Makerspace-Amiens-2025-26/MachineThatDraws-Groupe08/docs/images/pcb_3d.png

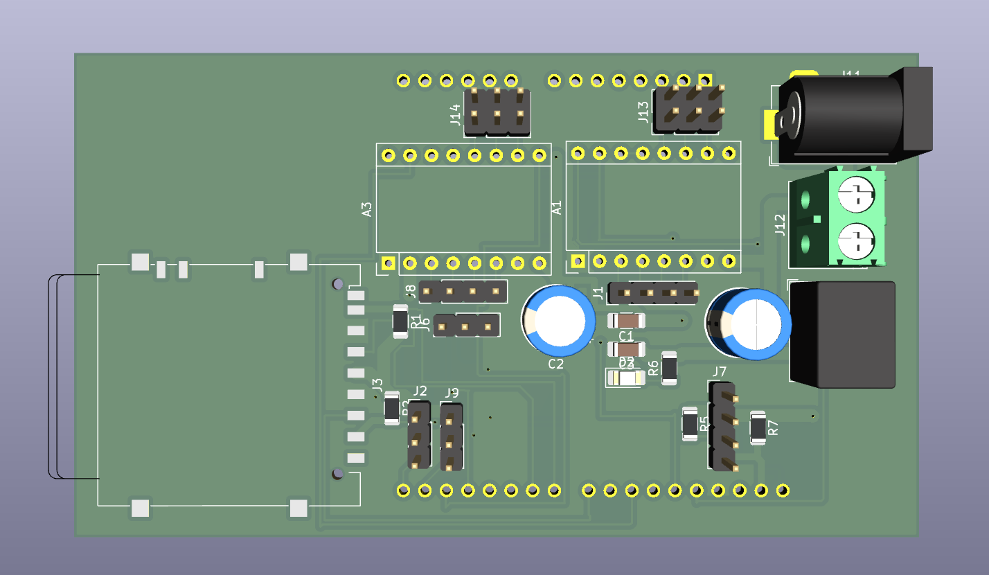
docs/images/pcb_3d.png
