Makerspace-Amiens-2025-26/MachineThatDraws-Groupe08/docs/images/pcb_routing.png

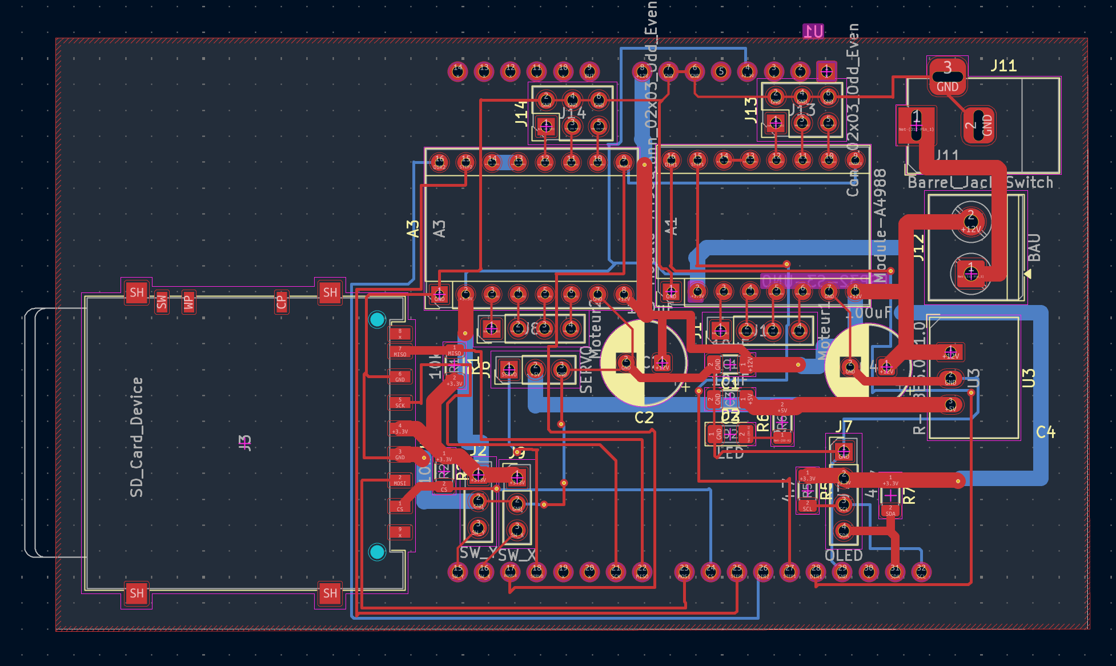
docs/images/pcb_routing.png
