Makerspace-Amiens-2025-26/MachineThatDraws-Groupe08/docs/images/poster_machine_1.png

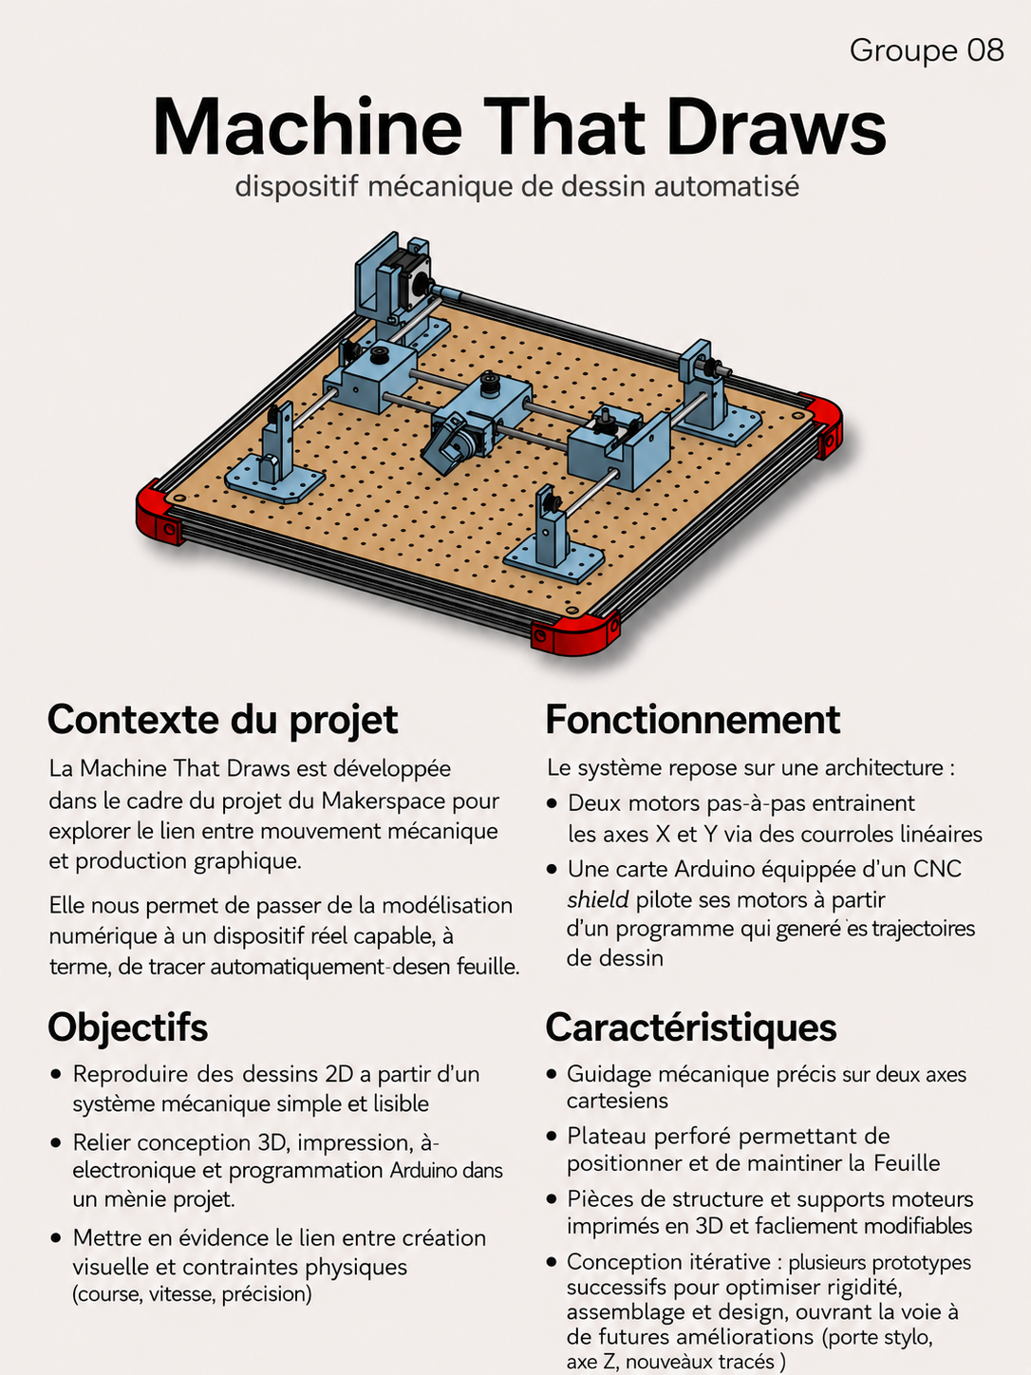
docs/images/poster_machine_1.png
