Makerspace-Amiens-2025-26/MachineThatDraws-Groupe08/docs/images/adaptateur.stl

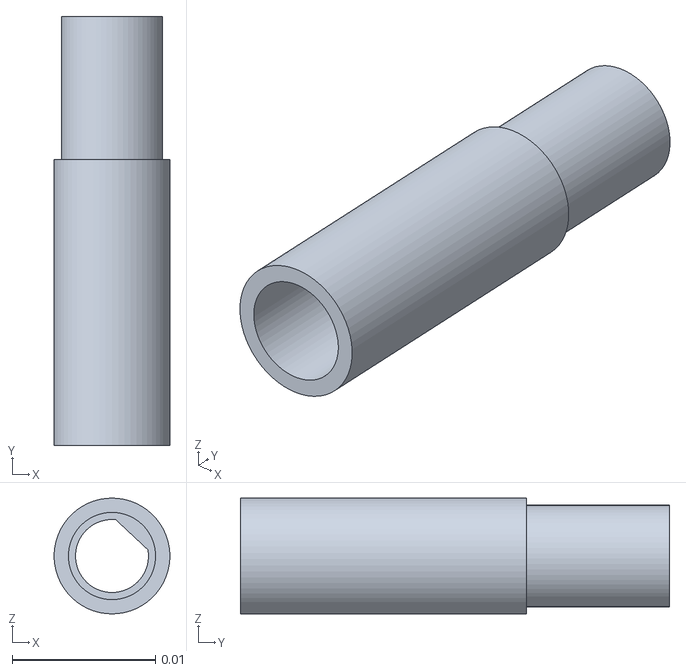
[picture p4: CAD file, 2026-06-24]
docs/images/adaptateur.stl
0.00809 x 0.03 x 0.0081
