Makerspace-Amiens-2025-26/MachineThatDraws-Groupe08/docs/images/support moteur.stl

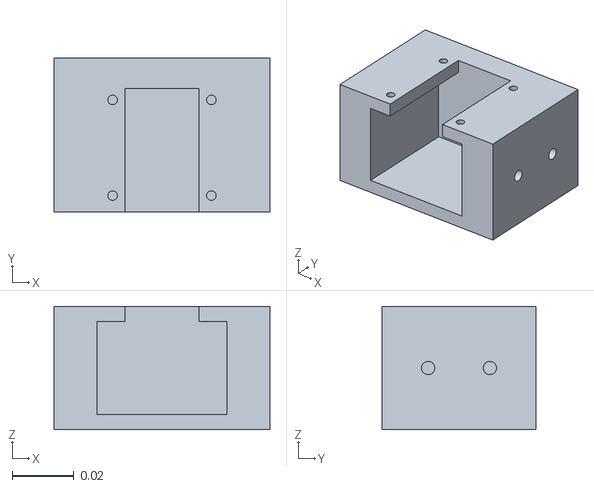
[picture p5: CAD file, 2026-06-24]
docs/images/support moteur.stl
0.07 x 0.05 x 0.04
