Makerspace-Amiens-2025-26/MachineThatDraws-Groupe08/docs/images/support double poulie.stl

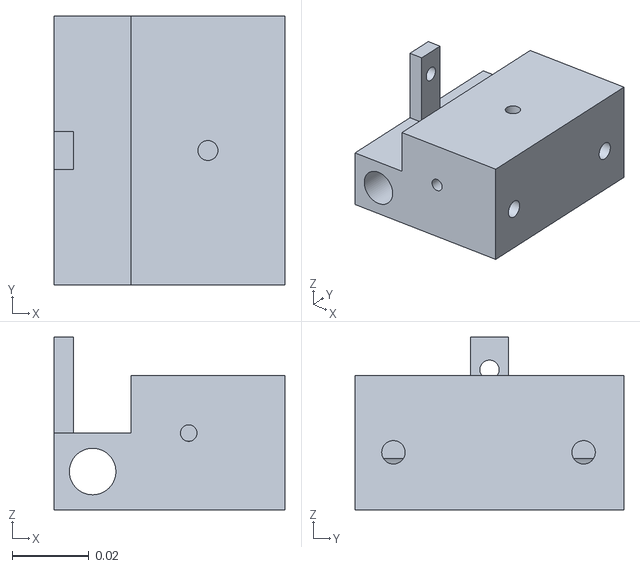
[picture p6: CAD file, 2026-06-24]
docs/images/support double poulie.stl
0.06 x 0.07 x 0.045
