Makerspace-Amiens-2025-26/MachineThatDraws-Groupe08/docs/images/support moteur double.stl

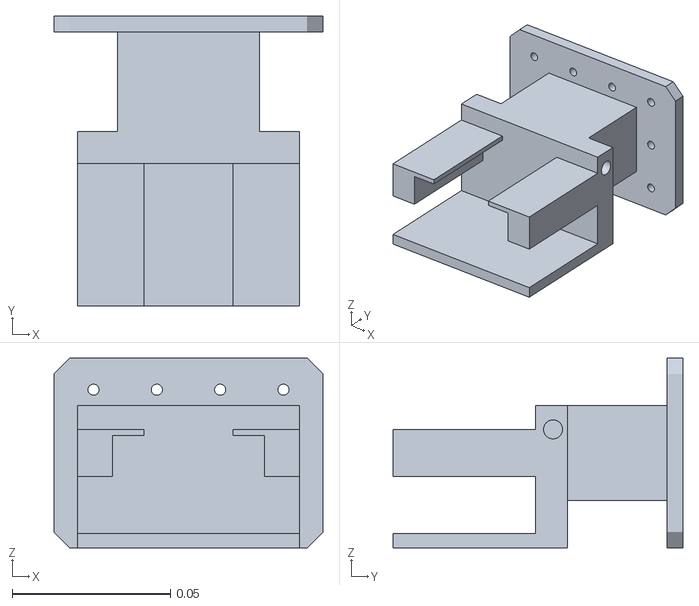
[picture p7: CAD file, 2026-06-24]
docs/images/support moteur double.stl
0.085 x 0.0915 x 0.06
