Makerspace-Amiens-2025-26/MachineThatDraws-Groupe08/docs/images/support barre métal.stl

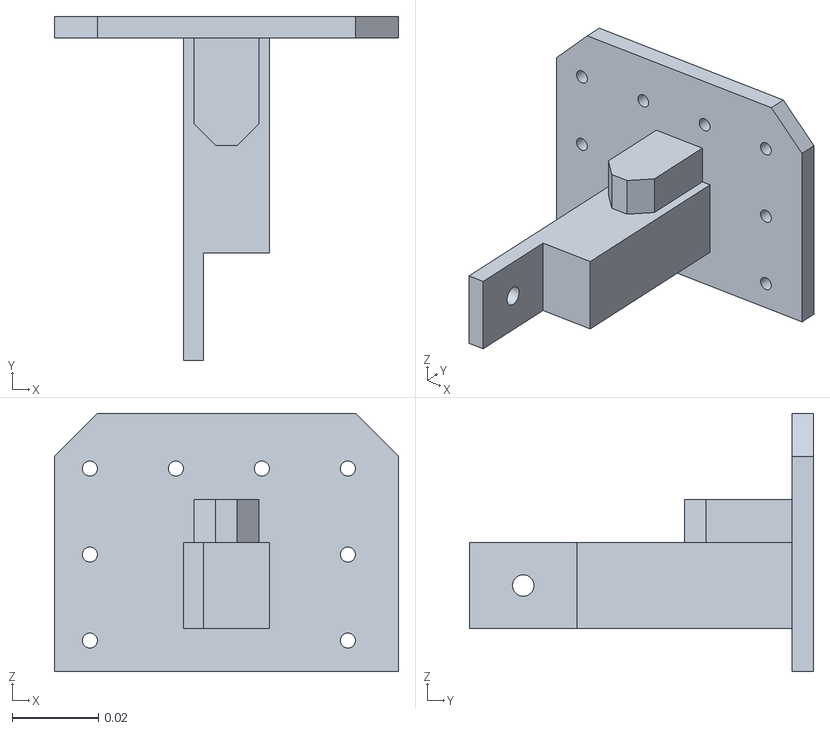
[picture p8: CAD file, 2026-06-24]
docs/images/support barre métal.stl
0.08 x 0.08 x 0.06
