Makerspace-Amiens-2025-26/MachineThatDraws-Groupe08/docs/images/support moteur simple.stl

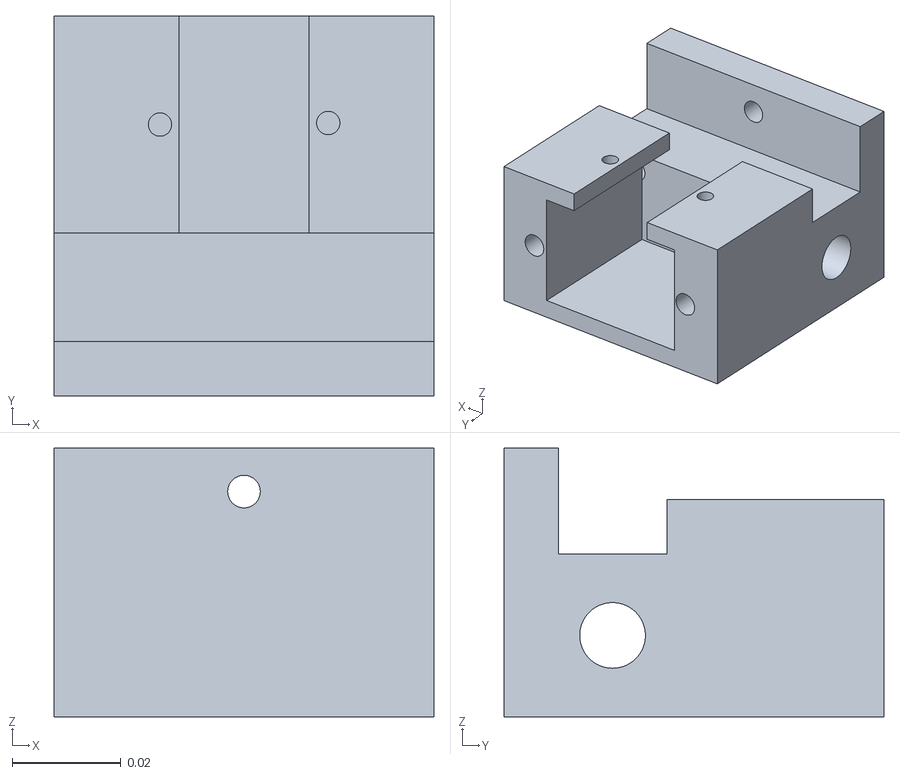
[picture p9: CAD file, 2026-06-24]
docs/images/support moteur simple.stl
0.07 x 0.07 x 0.0495
