Makerspace-Amiens-2025-26/MachineThatDraws-Groupe08/machine that draw.kicad_pcb

## KiCad design machine that draw.kicad_pcb (2026-05-12)

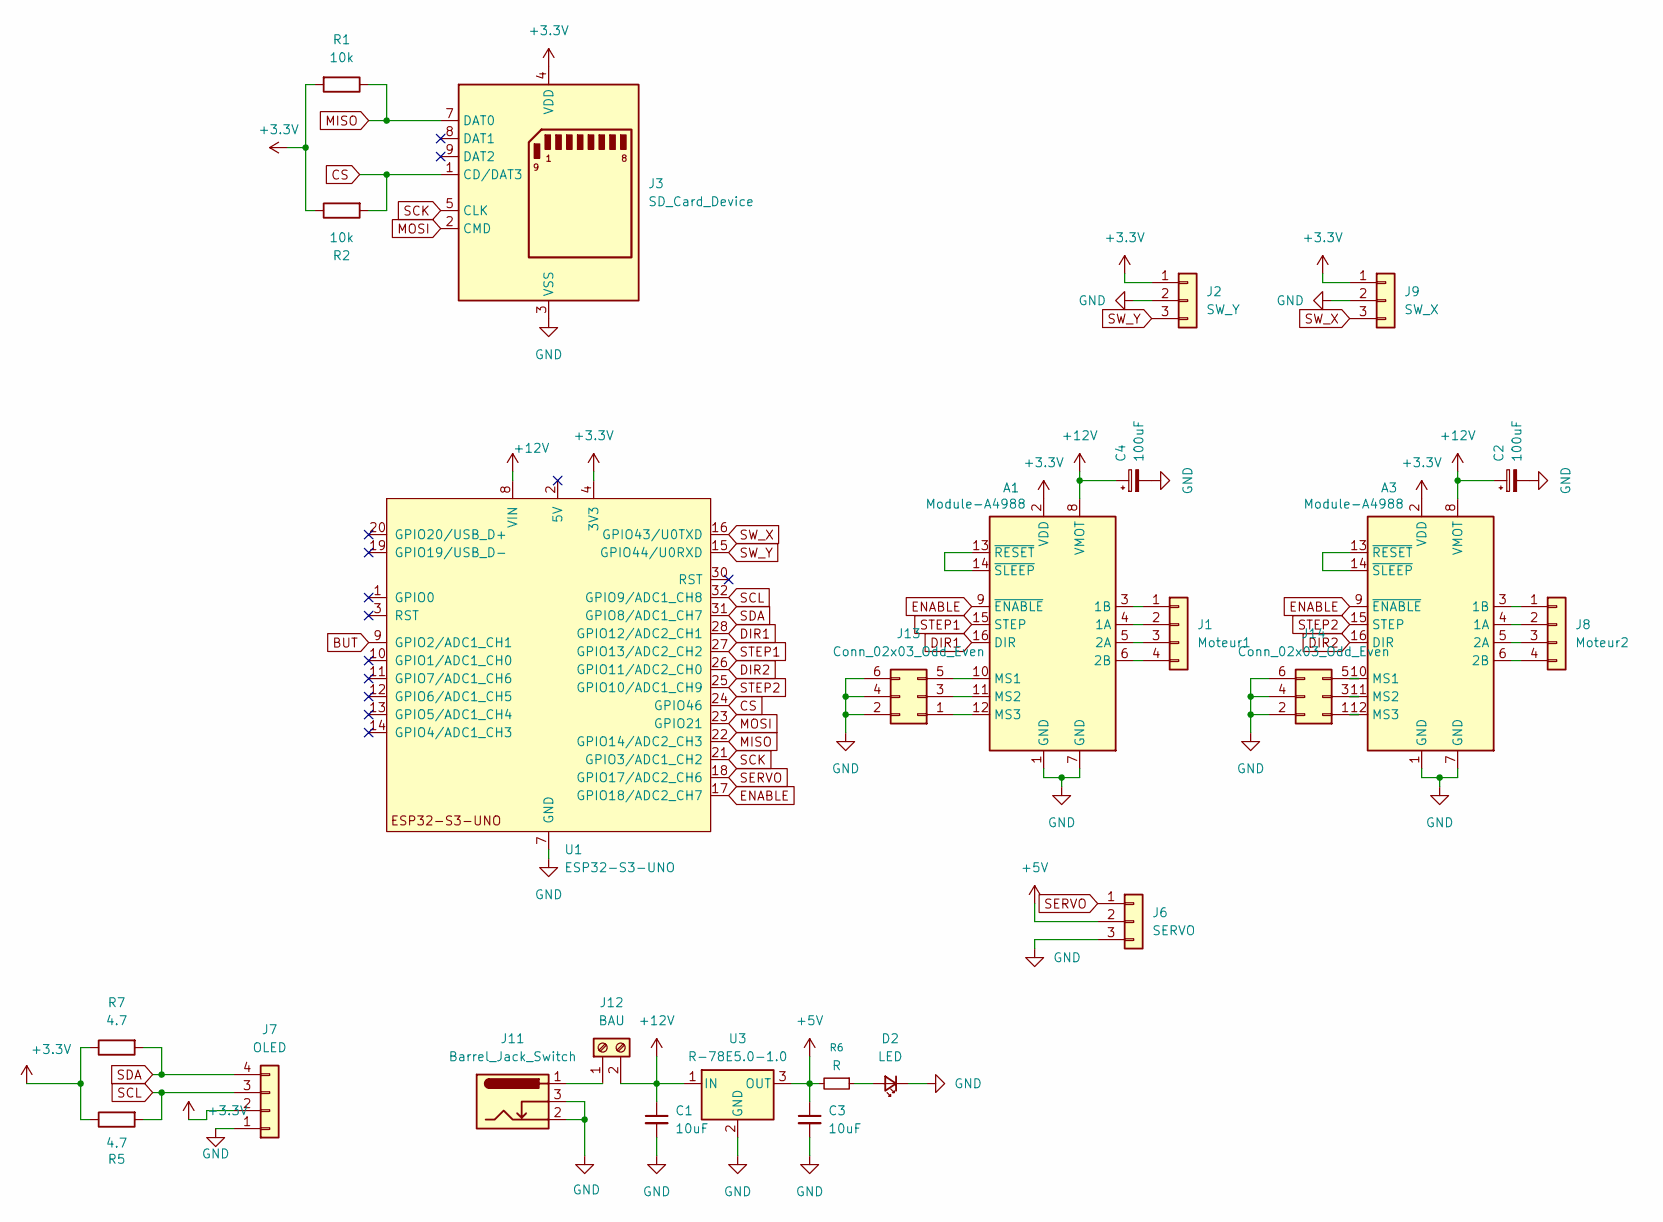
[picture p10: schematic machine that draw.kicad_sch]

Parts:
A1, A3: Module-A4988; Pololu_Breakout-16_15.2x20.3mm
C1, C3: 10uF; C_1206_3216Metric_Pad1.33x1.80mm_HandSolder
C2, C4: 100uF; CP_Radial_D8.0mm_P3.50mm
D2: LED; LED_1206_3216Metric_Pad1.42x1.75mm_HandSolder
J1: Moteur1; PinHeader_1x04_P2.54mm_Vertical
J2: SW_Y; PinHeader_1x03_P2.54mm_Vertical
J3: SD_Card_Device; SD_Hirose_DM1AA_SF_PEJ82
J6: SERVO; PinHeader_1x03_P2.54mm_Vertical
J7: OLED; PinHeader_1x04_P2.54mm_Vertical
J8: Moteur2; PinHeader_1x04_P2.54mm_Vertical
J9: SW_X; PinHeader_1x03_P2.54mm_Vertical
J11: Barrel_Jack_Switch; BarrelJack_Horizontal
J12: BAU; TerminalBlock_Phoenix_PT-1,5-2-5.0-H_1x02_P5.00mm_Horizontal
J13, J14: Conn_02x03_Odd_Even; PinHeader_2x03_P2.54mm_Vertical
R1, R2: 10k; R_1206
R5, R7: 4.7; R_1206
R6: R; R_1206
U1: ESP32-S3-UNO; ESP_S3_UNO
U3: R-78E5.0-1.0; Converter_DCDC_RECOM_R-78E-0.5_THT

Connections:
+3.3V: A1.2 (VDD), A3.2 (VDD), J2.1, J3.4 (VDD), J7.2, J9.1, R1.2, R2.1, R5.1, R7.1, U1.4 (3V3)
+5V: C3.1, J6.2, R6.2, U3.3 (OUT)
+12V: A1.8 (VMOT), A3.8 (VMOT), C1.1, C2.1, C4.1, J12.2, U1.8 (VIN), U3.1 (IN)
BUT: U1.9 (GPIO2/ADC1_CH1)
CS: J3.1 (CD/DAT3), R2.2, U1.24 (GPIO46)
DIR1: A1.16 (DIR), U1.28 (GPIO12/ADC2_CH1)
DIR2: A3.16 (DIR), U1.26 (GPIO11/ADC2_CH0)
ENABLE: A1.9 (~ENABLE), A3.9 (~ENABLE), U1.17 (GPIO18/ADC2_CH7)
GND: A1.1 (GND), A1.7 (GND), A3.1 (GND), A3.7 (GND), C1.2, C2.2, C3.2, C4.2, D2.1 (K), J2.2, J3.3 (VSS), J3.6 (VSS), J6.3, J7.1, J9.2, J11.2, J11.3, J13.2, J13.4, J13.6, J14.2, J14.4, J14.6, U1.6 (GND), U1.7 (GND), U1.29 (GND), U3.2 (GND)
MISO: J3.7 (DAT0), R1.1, U1.22 (GPIO14/ADC2_CH3)
MOSI: J3.2 (CMD), U1.23 (GPIO21)
unnamed: A1.4 (1A), J1.2
unnamed: A1.3 (1B), J1.1
unnamed: A1.5 (2A), J1.3
unnamed: A1.6 (2B), J1.4
unnamed: A1.10 (MS1), J13.5
unnamed: A1.11 (MS2), J13.3
unnamed: A1.12 (MS3), J13.1
unnamed: A1.13 (~RESET), A1.14 (~SLEEP)
unnamed: A3.4 (1A), J8.2
unnamed: A3.3 (1B), J8.1
unnamed: A3.5 (2A), J8.3
unnamed: A3.6 (2B), J8.4
unnamed: A3.10 (MS1), J14.5
unnamed: A3.11 (MS2), J14.3
unnamed: A3.12 (MS3), J14.1
unnamed: A3.13 (~RESET), A3.14 (~SLEEP)
unnamed: D2.2 (A), R6.1
unnamed: J11.1, J12.1
SCK: J3.5 (CLK), U1.21 (GPIO3/ADC1_CH2)
SCL: J7.3, R5.2, U1.32 (GPIO9/ADC1_CH8)
SDA: J7.4, R7.2, U1.31 (GPIO8/ADC1_CH7)
SERVO: J6.1, U1.18 (GPIO17/ADC2_CH6)
STEP1: A1.15 (STEP), U1.27 (GPIO13/ADC2_CH2)
STEP2: A3.15 (STEP), U1.25 (GPIO10/ADC1_CH9)
SW_X: J9.3, U1.16 (GPIO43/U0TXD)
SW_Y: J2.3, U1.15 (GPIO44/U0RXD)

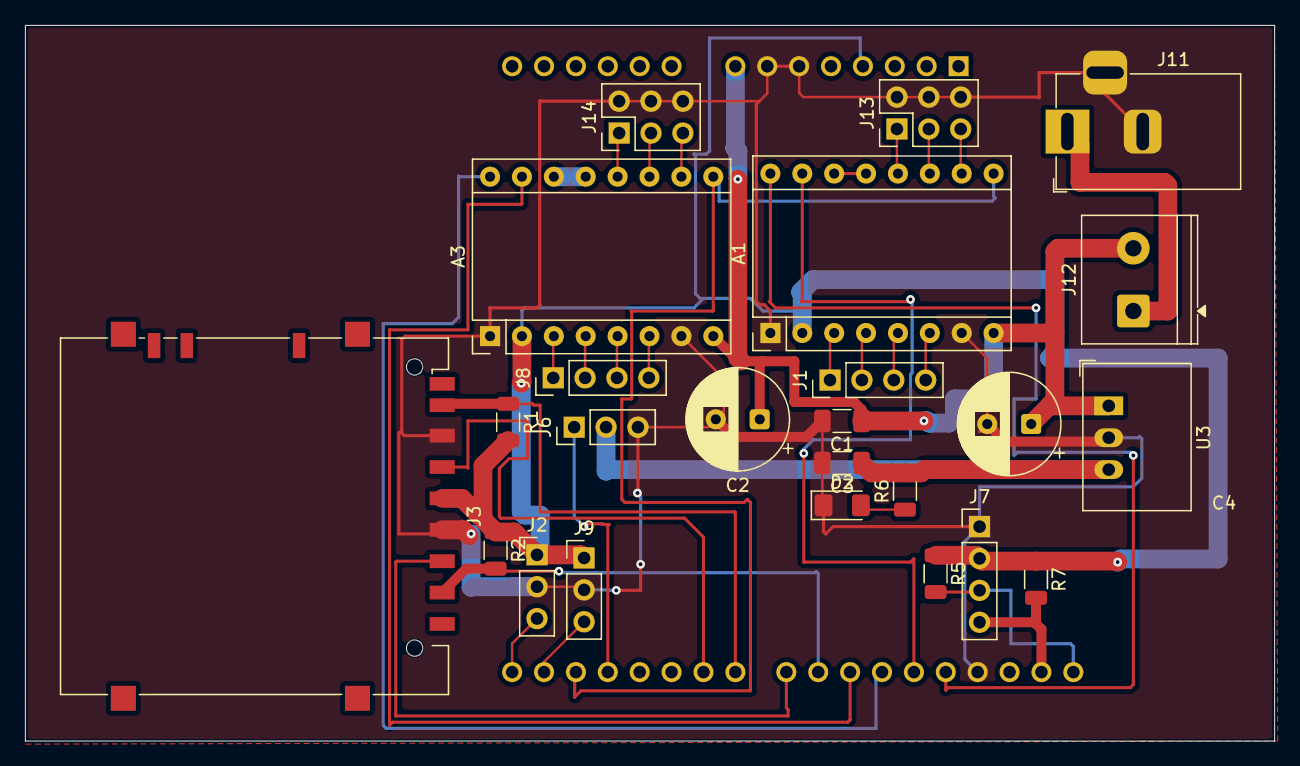
[picture p11: board machine that draw.kicad_pcb from above]

Board: 2 copper layers, 99.5 x 57.0 mm, 25 parts (0 on the bottom side), 36 nets.
