Makerspace-Amiens-2025-26/MachineThatDraws-Groupe08/(commit log)

2026-06-28 video et assemblage
2026-06-28 pcb image
